dilshan/star-pointer/README.md

# StarPointer - Electronic Finderscope

StarPointer is a virtual electronic finderscope for astronomical telescopes. This device works with [*Stellarium*](http://stellarium.org) and helps the observer identify objects in the sky.

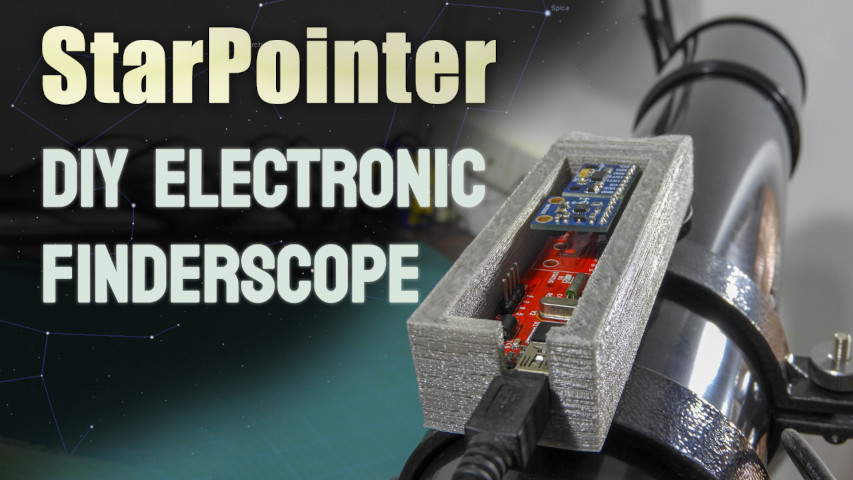
[picture p1: starpointer-thumbnail.jpg]
StarPointer - DIY Electronic Finderscope (https://youtu.be/OOE7l4sul2Y)


This sensor kit builds around the STM32F103C8 microcontroller, ADXL345 3-axis accelerometer, and HMC5883L 3-axis magnetometer. It communicates with the PC using the inbuilt USB peripheral of the STM32F103C8 microcontroller.

StarPointer is an open-source project. This repository has all the schematics, PCB design files, firmware source codes, and application source codes.

The complete documentation of this project is in the [wiki section](https://github.com/dilshan/star-pointer/wiki) of this repository. The PCB Gerber files and compiled binaries are also available in the [release section](https://github.com/dilshan/star-pointer/releases) of this repository. The PCB of the StarPointer can also [order from the *PCBWay* website](https://www.pcbway.com/project/shareproject/StarPointer_virtual_electronic_finderscope_2c7c17a4.html).

All the content of this project is distributed under the terms of the following license:

-   Hardware License: [CERN-OHL-W 2.0](https://ohwr.org/cern_ohl_w_v2.txt)
-   Software License: [MIT](https://github.com/dilshan/star-pointer/blob/main/LICENSE)
-   [Documentation](https://github.com/dilshan/star-pointer/wiki) License: [CC BY 4.0](https://creativecommons.org/licenses/by/4.0/)

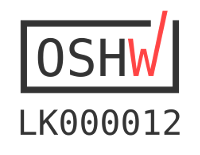
[picture p2: resources/oshwa-LK000012-small.png]
LK000012 (https://certification.oshwa.org/lk000012.html)
