dilshan/star-pointer/enclosure/readme.md

This enclosure design is available at [tinkercad.com](https://www.tinkercad.com/things/ifxZDN9YyqG)
