dilshan/star-pointer/sync/telescope.png

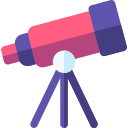
sync/telescope.png
