dilshan/star-pointer/enclosure/StarPointer.stl

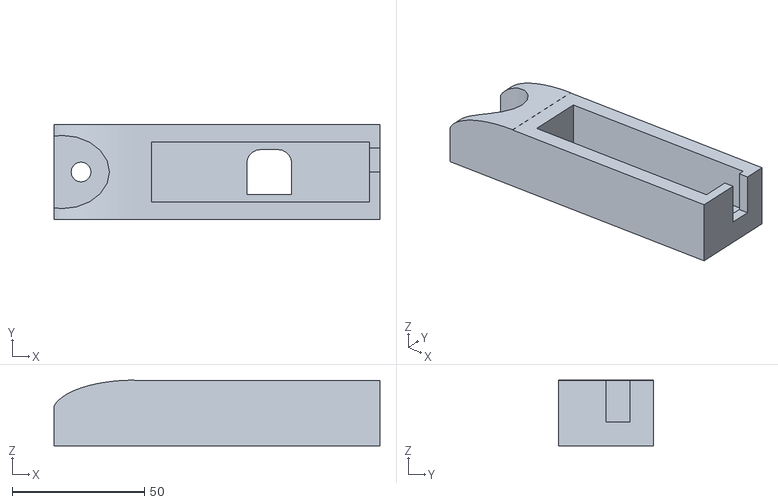
[picture p4: CAD file, 2022-06-18]
enclosure/StarPointer.stl
123.4 x 36.0 x 24.9
