dilshan/star-pointer/design/starpointer/starpointer.kicad_pcb

## KiCad design design/starpointer/starpointer.kicad_pcb (2022-06-16)

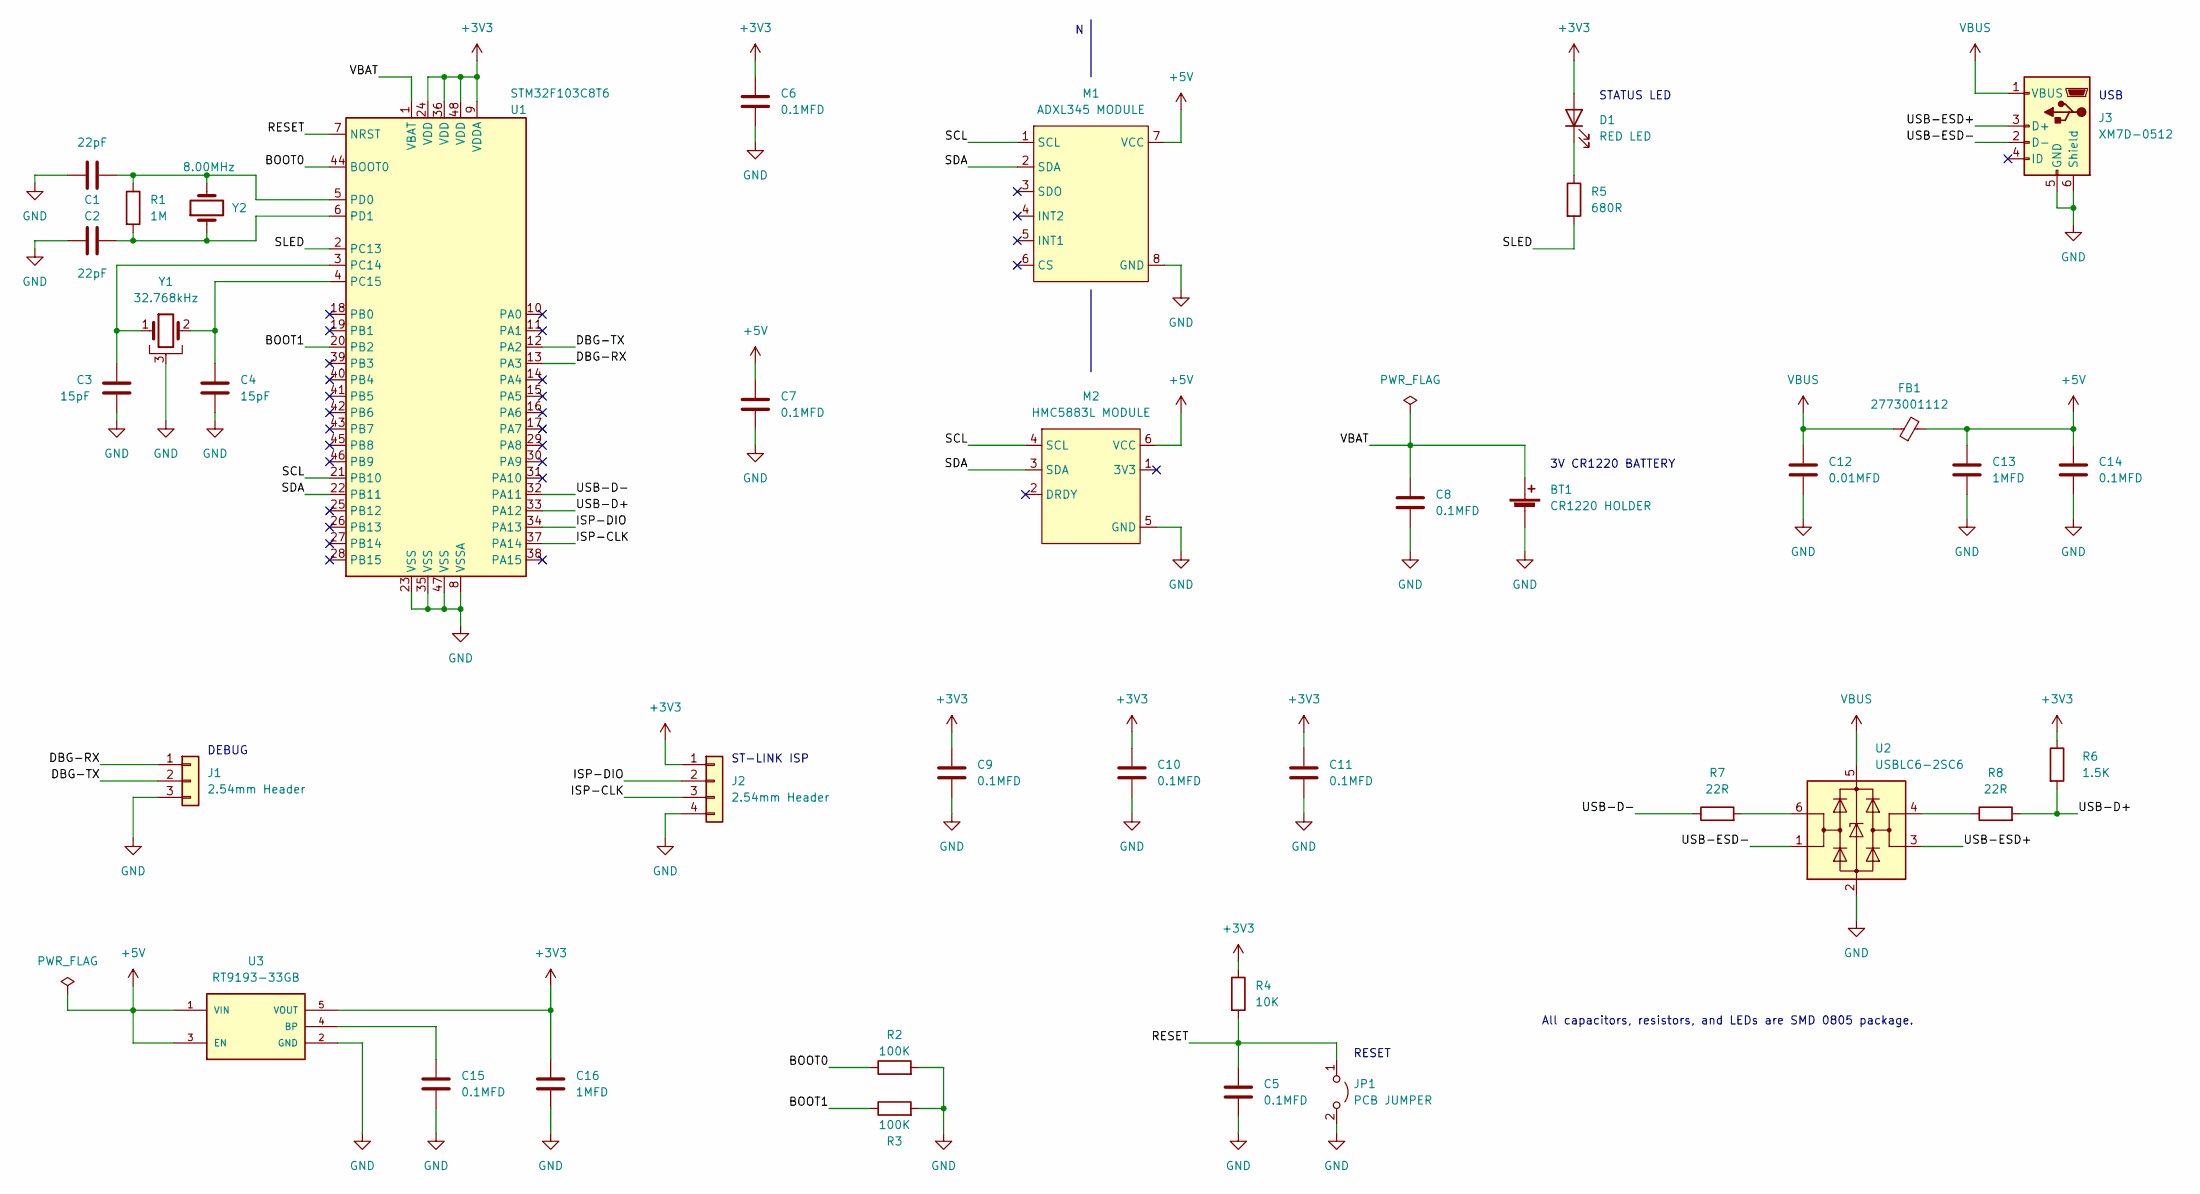
[picture p6: schematic starpointer.kicad_sch, Star Pointer]

Parts:
BT1: CR1220 HOLDER; MPD_BC501SM-TR
C1, C2: 22pF; C_0805_2012Metric_Pad1.18x1.45mm_HandSolder
C3, C4: 15pF; C_0805_2012Metric_Pad1.18x1.45mm_HandSolder
C5, C6, C7, C8, C9, C10, C11, C14, C15: 0.1MFD; C_0805_2012Metric_Pad1.18x1.45mm_HandSolder
C12: 0.01MFD; C_0805_2012Metric_Pad1.18x1.45mm_HandSolder
C13, C16: 1MFD; C_0805_2012Metric_Pad1.18x1.45mm_HandSolder
D1: RED LED; LED_0805_2012Metric_Pad1.15x1.40mm_HandSolder
FB1: 2773001112; L_Axial_L5.0mm_D3.6mm_P10.00mm_Horizontal_Murata_BL01RN1A2A2
J1: 2.54mm Header; PinHeader_1x03_P2.54mm_Vertical
J2: 2.54mm Header; PinHeader_1x04_P2.54mm_Vertical
J3: XM7D-0512; OMRON_XM7D-0512
JP1: PCB JUMPER; SolderJumper-2_P1.3mm_Open_Pad1.0x1.5mm
M1: ADXL345 MODULE
M2: HMC5883L MODULE
R1: 1M; R_0805_2012Metric_Pad1.20x1.40mm_HandSolder
R2, R3: 100K; R_0805_2012Metric_Pad1.20x1.40mm_HandSolder
R4: 10K; R_0805_2012Metric_Pad1.20x1.40mm_HandSolder
R5: 680R; R_0805_2012Metric_Pad1.20x1.40mm_HandSolder
R6: 1.5K; R_0805_2012Metric_Pad1.20x1.40mm_HandSolder
R7, R8: 22R; R_0805_2012Metric_Pad1.20x1.40mm_HandSolder
U1: STM32F103C8T6; LQFP-48_7x7mm_P0.5mm
U2: USBLC6-2SC6; SOT-23-6
U3: RT9193-33GB; SOT-23-5_HandSoldering
Y1: 32.768kHz; Crystal_AT310_D3.0mm_L10.0mm_Horizontal_1EP_style1
Y2: 8.00MHz; Crystal_HC49-U_Vertical

Connections:
+3V3: C6.1, C9.1, C10.1, C11.1, C16.1, D1.2 (A), J2.1, R4.1, R6.1, U1.9 (VDDA), U1.24 (VDD), U1.36 (VDD), U1.48 (VDD), U3.5 (VOUT)
+5V: C7.1, C13.1, C14.1, FB1.2, M1.7 (VCC), M2.6 (VCC), U3.1 (VIN), U3.3 (EN)
/BOOT0: R2.1, U1.44 (BOOT0)
/BOOT1: R3.1, U1.20 (PB2)
/DBG-RX: J1.1, U1.13 (PA3)
/DBG-TX: J1.2, U1.12 (PA2)
/ISP-CLK: J2.3, U1.37 (PA14)
/ISP-DIO: J2.2, U1.34 (PA13)
/RESET: C5.1, JP1.1 (A), R4.2, U1.7 (NRST)
/SCL: M1.1 (SCL), M2.4 (SCL), U1.21 (PB10)
/SDA: M1.2 (SDA), M2.3 (SDA), U1.22 (PB11)
/SLED: R5.2, U1.2 (PC13)
/USB-D+: R6.2, R8.2, U1.33 (PA12)
/USB-D-: R7.1, U1.32 (PA11)
/USB-ESD+: J3.3 (D+), U2.3 (I/O2)
/USB-ESD-: J3.2 (D-), U2.1 (I/O1)
/VBAT: BT1.1 (+), C8.1, U1.1 (VBAT)
GND: BT1.2 (-), C1.1, C2.1, C3.2, C4.2, C5.2, C6.2, C7.2, C8.2, C9.2, C10.2, C11.2, C12.2, C13.2, C14.2, C15.2, C16.2, J1.3, J2.4, J3.5 (GND), J3.6 (Shield), JP1.2 (B), M1.8 (GND), M2.5 (GND), R2.2, R3.2, U1.8 (VSSA), U1.23 (VSS), U1.35 (VSS), U1.47 (VSS), U2.2 (GND), U3.2 (GND), Y1.3
unnamed: C1.2, R1.1, U1.5 (PD0), Y2.2
unnamed: C2.2, R1.2, U1.6 (PD1), Y2.1
unnamed: C3.1, U1.3 (PC14), Y1.1
unnamed: C4.1, U1.4 (PC15), Y1.2
unnamed: C15.1, U3.4 (BP)
unnamed: D1.1 (K), R5.1
unnamed: R7.2, U2.6 (I/O1)
unnamed: R8.1, U2.4 (I/O2)
VBUS: C12.1, FB1.1, J3.1 (VBUS), U2.5 (VBUS)

Notes on the sheet:
3V CR1220 BATTERY
DEBUG
STATUS LED
All capacitors, resistors, and LEDs are SMD 0805 package.
ST-LINK ISP
RESET
USB

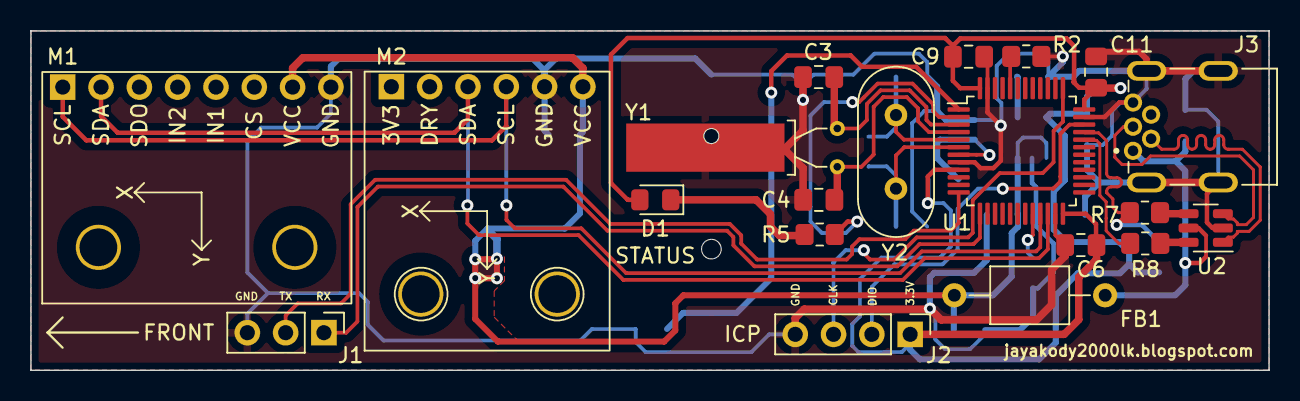
[picture p7: board starpointer.kicad_pcb from above]

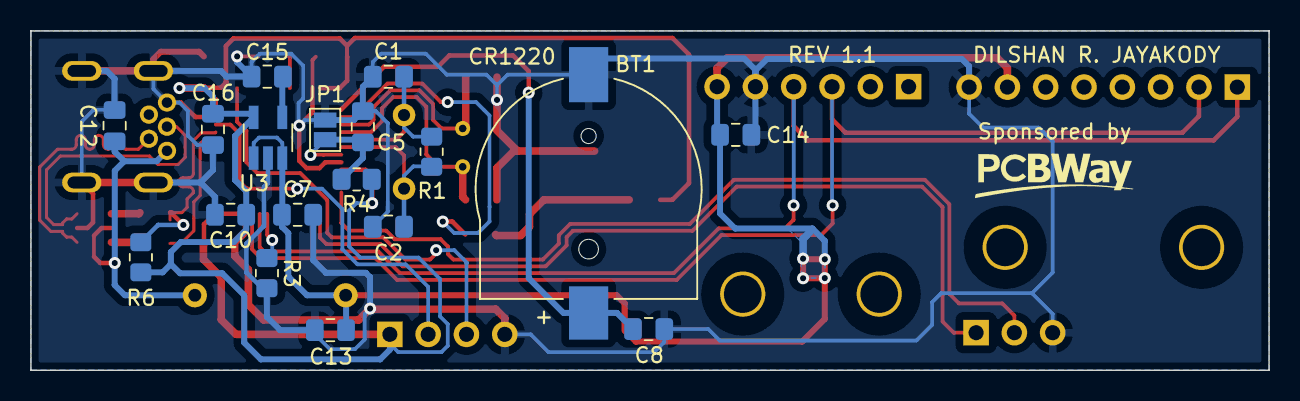
[picture p8: board starpointer.kicad_pcb from below]

Board: 2 copper layers, 82.1 x 22.5 mm, 38 parts (18 on the bottom side), 27 nets.
