dilshan/star-pointer/(commit log)

2022-01-17 Add sensor commands to set UTC date/time and location.
2022-01-18 Add sensor configuration update flow with error handling.
2022-01-18 Add application icon. :framed_picture:
2022-01-19 Set sensor command formats similar to LX200 protocol.
2022-01-20 Provide sync utility support on STM32F103C8 firmware.
2022-01-20 Fix pitch angle issue with relative to the magnetometer.
    [transform.c]
2022-01-23 Add battery backup support to RTC. Fix issues in RTC year.
    [datetime.c, datetime.h, logger.h, main.c, protocol.c, sysrtc.c]
2022-01-23 Modify update routines to send UTC time to the sensor.
2022-01-25 Add RA and DEC offset support into the sensor readings.
2022-01-29 Initial version of Star Pointer schematic and PCB.
    [starpointer.kicad_pcb, starpointer.kicad_sch]
2022-02-01 Add note about the component types. Add PDF version of the schematic.
    [starpointer.kicad_sch]
2022-06-16 Fix USB connection issue due to the missing pull-up in USB-D+ line.
    [starpointer.kicad_pcb, starpointer.kicad_sch]
2022-06-16 Add PDF version of the StarPointer schematic.
2022-06-17 Add SVG image of the StarPointer PCB.
2022-06-17 :framed_picture: Add StarPointer thumbnail image.
2022-06-18 Add board and enclosure dimensions.
2022-06-18 Add STL file of the StarPointer enclosure.
    [StarPointer.stl]
2022-06-25 Add PCBWay order address.
